SangHyeon-Shin/Pond-Water-Quality-IOT-System/docs/hardware.md

# 하드웨어·배선·전원

부품 목록과 가격은 [`hardware/bom.xlsx`](../hardware/bom.xlsx)([CSV](../hardware/bom.csv))에 있습니다.

## 1. 연못 노드 (Arduino Uno)

| 신호 | Uno 핀 | 비고 |
|---|---|---|
| 탁도 SEN0189 신호 | **A0** | 센서 보드 스위치를 **A(아날로그)** 로 둡니다 |
| TDS 신호 | **A1** | VCC는 5V, 또는 간섭 대책 시 **D5** (4절) |
| pH 보드 신호 | **A2** | 보드 세대(V1/V2)는 `PH_BOARD_VERSION` |
| 용존산소 SEN0237 신호 (선택) | **A3** | `ENABLE_DO_SENSOR 1` |
| DS18B20 DATA | **D2** | 4.7 kΩ 풀업을 5V에 연결 |
| TDS 보드 VCC (선택) | **D5** | `PIN_TDS_POWER 5` (TDS 보드 소비전류 3~6 mA) |
| 릴레이 IN (선택) | **D6** | `ENABLE_AERATOR_CONTROL 1` (6절) |
| nRF24 CE / CSN | **D7 / D8** | |
| nRF24 SCK / MISO / MOSI | **D13 / D12 / D11** | SPI 버스. D13(내장 LED)은 다른 용도로 쓰지 않습니다 |
| nRF24 어댑터 보드 VCC | **5V** | 어댑터의 3.3V 레귤레이터 사용, 10~100 µF 커패시터 추가 |

모든 핀은 [`firmware/pond_node/config.h`](../firmware/pond_node/config.h)에서 바꿀 수 있습니다.
2024년 회로도(TDS 전원 제어·DO·릴레이 이전 구성): [`images/circuit-2024.png`](images/circuit-2024.png)

## 2. 게이트웨이

### A. NodeMCU V2 (권장, BOM에 이미 있음)

| nRF24 (어댑터 보드) | NodeMCU |
|---|---|
| CE | **D2** (GPIO4) |
| CSN | **D1** (GPIO5) |
| SCK | **D5** (GPIO14) |
| MISO | **D6** (GPIO12) |
| MOSI | **D7** (GPIO13) |
| VCC | USB 5V가 나오는 핀(Amica V2: VIN, LoLin V3: VU) |
| GND | GND |

Uno와 ESP-01 두 보드를 NodeMCU 1장으로 대체합니다. AT 펌웨어, SoftwareSerial이 필요 없고 RAM이 충분합니다.
어댑터 입력 전압이 4.5 V 이상인지 멀티미터로 확인하세요(레귤레이터 강하 전압 때문).

### B. Arduino Uno + ESP-01 (2024 구성)

| 신호 | Uno |
|---|---|
| ESP-01 TX → | **D2** (SoftwareSerial RX) |
| ESP-01 RX ← | **D3** (SoftwareSerial TX, 어댑터 보드의 레벨 변환 경유) |
| nRF24 CE / CSN / SPI | 노드와 동일 (D7 / D8 / D11~13) |

ESP-01은 AT 펌웨어 보드레이트를 9600으로 한 번 설정해야 합니다([blynk-setup.md](blynk-setup.md#4-esp-01-at-펌웨어-설정-uno-게이트웨이만)).

## 3. 무선 링크 (nRF24L01+PA+LNA)

양쪽 설정은 [`PondProtocol.h`](../firmware/libraries/PondCore/src/PondProtocol.h) 한 곳에 있어 항상 일치합니다.

| 항목 | 2024 | 현재 | 근거 |
|---|---|---|---|
| 데이터율 | 1 Mbps (기본값) | **250 kbps** | 수신감도 −85 → **−94 dBm** (nRF24L01+ 데이터시트) |
| 출력 | `PA_LOW` | **`PA_HIGH`** | 연못↔교실 거리. 전원 불안정 시 `PA_LOW`로 되돌리고 커패시터 확인 |
| 채널 | 76 (암묵적) | **76 (명시)** | 2,476 MHz |
| 페이로드 | 32 B 고정, 16 B 사용 | **29 B** (버전·순번·상태 포함) | |
| 재전송 | 15회 | 15회, 1.5 ms 간격 | 250 kbps에 필요한 간격 |

- **채널 선택**: nRF24 채널 n은 2400+n MHz입니다. 2.4 GHz ISM 대역은 2,483.5 MHz까지이므로 **0~83번만** 사용합니다(84 이상은 대역 밖). Wi-Fi 1/6/11번 채널은 대략 2,401~2,473 MHz를 차지하므로 74~83번이 겹침이 적습니다. 현장 Wi-Fi 채널은 스캐너 앱으로 확인하세요.
- **복제 칩**: 시리얼에 `data rate not supported`가 나오면 250 kbps를 지원하지 않는 칩입니다. 양쪽 모두 `RF24_1MBPS`로 바꿉니다.
- 안테나는 수직으로 세우고, 금속 함체 밖으로 내고, 가능하면 시야를 확보합니다.

## 4. pH·TDS 간섭

TDS 프로브는 물에 교류 신호를 흘려 측정하므로, 같은 물에 있는 pH 전극 측정을 흔들 수 있습니다.
DFRobot도 두 센서를 같은 용기에서 함께 쓸 때 간섭을 안내하고 신호 절연 모듈(DFR0504)을 판매합니다.
2024 회로도는 두 프로브를 다른 비커에 두었지만, 현장에서는 한 묶음으로 같은 물에 넣었습니다.

| 방법 | 비용 | 설정 |
|---|---|---|
| **TDS 전원 시분할** (권장, 추가 부품 없음) | 0원 | TDS 보드 VCC를 5V에서 **D5**로 옮기고 `PIN_TDS_POWER 5`. 노드는 TDS를 끈 채로 pH·탁도·DO를 측정한 뒤, TDS를 켜고 2 s 예열 후 측정하고 다시 끕니다 |
| 신호 절연 모듈 DFR0504 | 별도 구매 | pH 보드와 Uno 사이에 연결 |

간섭 여부는 물 한 컵에서 TDS 프로브를 넣었다 뺐다 하며 유지보수 모드(`status`)의 pH 전압 변화를 보면 확인할 수 있습니다.

## 5. 전원

### 소비전류 (참고치)

| 부하 | 전류 | 출처 |
|---|---|---|
| Arduino Uno 보드 | 동작 약 50 mA, 슬립 약 35 mA | 공개 측정 사례(USB 칩·레귤레이터·LED가 슬립 중에도 소비) |
| 탁도 SEN0189 | 최대 40 mA, 상시 | 제조사 사양 |
| TDS 보드 | 3~6 mA | 제조사 사양. D5 전원 제어 시 측정 중에만 |
| DS18B20 | 1.5 mA 이하(변환 중) | 데이터시트 |
| nRF24 PA+LNA | 송신 순간 최대 약 115 mA | 모듈 사양. 현재 펌웨어는 60 s마다 수 ms만 켜고 나머지는 powerDown |
| 릴레이 코일 (선택) | 약 70 mA | NC 배선이면 폭기를 끌 때만 통전 |

| 펌웨어 | 평균 전류 (추정) | 10,000 mAh 보조배터리 (약 31 Wh 사용 가능 가정) |
|---|---|---|
| 2024 (쉬지 않고 송신·재전송) | 약 110~160 mA | 약 1.5~2.5일 |
| 현재 (60 s 주기, 슬립, 무선 powerDown) | 약 75~90 mA | 약 3~3.5일 |

추정치이므로 USB 전류계로 실측해 보세요. 남은 큰 소비는 **Uno 보드 자체**와 **상시 켜진 탁도 센서**입니다.
더 줄이려면 센서 전원을 MOSFET으로 차단하거나 저전력 보드(3.3 V Pro Mini 등)로 바꿔야 합니다(하드웨어 변경).

- **보조배터리 자동 꺼짐**: 일부 보조배터리는 부하가 수십 mA 이하로 떨어지면 출력을 끕니다. 슬립 후 노드가 멈추면 "저전류/IoT 모드"가 있는 제품을 쓰거나 아래 태양광 구성을 사용하세요.
- **태양광 구성 (개략 계산)**: 평균 0.4 W × 24 h ≈ **10 Wh/일**. 2일 무일조 대비 배터리 약 20 Wh(18650 3,000 mAh 2개 병렬 ≈ 22 Wh), 패널은 하루 일사 3~4시간·효율 70 % 기준 약 4 W가 필요하므로 여유를 두어 **10 W**, 태양광 충전 컨트롤러 + 5 V 승압기를 사용합니다.

## 6. 폭기 장치 릴레이 (선택)

```
태양광 폭기 키트 출력(+) ──── 릴레이 COM
                              릴레이 NC ──── 펌프(+)
태양광 폭기 키트 출력(−) ─────────────────── 펌프(−)
```

- **NC(상시 닫힘) 접점**에 연결합니다. 릴레이가 꺼져 있으면(노드 고장·전원 차단 포함) 펌프가 계속 돕니다.
  펌웨어 설정 `AERATOR_ON_WHEN_RELAY_ENERGIZED 0`이 이 배선에 맞춘 기본값입니다.
- 릴레이 접점 정격이 펌프 전류보다 커야 합니다(38 W 키트라면 키트 전압 기준 전류를 계산하세요).
- 대부분의 5 V 릴레이 모듈은 IN이 LOW일 때 동작합니다(`RELAY_ACTIVE_LOW 1`).
- 동작: DO < 5.0 mg/L이면 즉시 ON, DO > 7.0 mg/L이고 15분 이상 돌았으면 OFF.
  **DO가 무효이거나 DO 센서가 교정 전이면 항상 ON**입니다. 기준값은 `config.h`에서 조정합니다.

## 7. 설치·방수·유지관리

- 함체의 케이블 인입부는 **케이블 글랜드**로 막고 실리카겔을 넣습니다.
- 탁도 센서 상단(전자부)은 방수가 아니므로 물 밖에 두고(3D 프린팅 홀더), 직사광선을 가립니다.
- 프로브는 가장자리·바닥 침전물에서 떨어진 일정 깊이(예: 20~30 cm)에 고정합니다. 2024 현장 시험은 가장자리 수초 사이였습니다.
- 권장 점검 주기: 탁도 광학창·TDS 전극 세척 매주, pH 재교정 매월(전극은 마르지 않게 보관).
