SangHyeon-Shin/Pond-Water-Quality-IOT-System/CHANGELOG.md

# 변경 내역

## v2.0.0 — 2026-10-31

2024 버전 코드 리뷰(2026-10)에서 확인한 문제를 반영했습니다.
2024 코드는 커밋 `37dee70`에서 볼 수 있습니다.

### 보안

- Blynk 토큰과 Wi-Fi 비밀번호를 코드에서 제거하고 `secrets.h`(git 제외)로 분리했습니다.
  `secrets.h`가 없으면 컴파일이 안내와 함께 멈추고, CI가 토큰 하드코딩을 검사합니다.
  **이미 공개된 값의 폐기는 저장소 소유자가 직접 해야 합니다** → [SECURITY.md](SECURITY.md)

### 측정 정확도 (연못 노드)

| 2024 동작 | 영향 | 수정 |
|---|---|---|
| TDS 온도보상에 쓰는 전역 `temperature`에 값이 대입되지 않음 → 0 °C로 계산, 보상계수 0.5 | TDS 과대: 수온 2 °C에서 1.07배, 30 °C에서 2.09배. Blynk 화면의 179.71 ppm은 실제 약 96 ppm | 측정 수온으로 보정. 수온이 무효면 25 °C로 보정하고 상태 비트 표시 |
| `ADC_NTU[i] >= z;`가 효과 없는 문장(`if` 누락) | 탁도가 원시값 1개 | 20개 샘플 강건 평균 |
| 탁도 직선식이 교정되지 않음, 음수 처리 없음 | 맑은 수돗물이 약 146 NTU | 2점 교정, 0 미만 차단. 교정 전 값은 상태 비트로 구분 |
| pH `Offset 0.00`, V1 예제식만 사용 (BOM은 V2 보드) | 교정 없음 | V1/V2 모두 쓰는 2점 교정, EEPROM 저장 |
| 루프당 `getTemp()` 2회, 변환 대기 없음, CRC 미검사, 오류값 −1000 송신 | 이전 변환값이나 85 °C(전원 투입값)를 읽을 수 있음, 그래프에 가짜 값 | 측정 1회, 750 ms 대기, CRC 검사, 오류는 NaN + 상태 비트 |
| pH·TDS 프로브를 같은 물에서 동시에 구동 | 상호 간섭 가능 | TDS 전원 시분할 옵션 `PIN_TDS_POWER` |
| ADC 기준을 5.00 V로 고정 가정 | 공급전압 3 % 오차 = pH 약 0.2 오차 | 내부 기준으로 공급전압 측정(`cal vcc`로 보정) |
| pH 평균 배열이 0으로 시작 | 기동 직후 약 40회 pH 과소 | 측정마다 새 샘플 40개 |

### 통신·전력

- 송신 주기: `lastSampleTime`이 갱신되지 않아 초당 약 11회 송신하던 것을 **60초에 1회**로 바꿨습니다.
  2024 구성을 모델링한 시뮬레이션에서 송신의 약 90 %가 재전송 실패였습니다.
- 게이트웨이가 수신 버퍼를 매번 모두 비웁니다(2024: 1초에 1개만 읽어 나머지 손실·지연).
- 무선: 250 kbps(수신감도 −85 → −94 dBm), `PA_HIGH`, 채널·페이로드·재전송을 명시하고 모듈 응답을 확인해 재초기화합니다.
- 측정 사이에 슬립하고 무선 모듈을 끕니다. 평균 전류 추정 110~160 mA → 75~90 mA.
- 노드 무응답 감지(V8, `node_offline` 이벤트). 무효 값은 대시보드로 보내지 않습니다.
- 게이트웨이가 Wi-Fi 실패 시 `setup()`에서 무한 대기하지 않습니다.
- 패킷 v2(29 B): 버전, 노드 ID, 순번(손실률 계산), 상태 비트, 공급전압, DO, 폭기 상태를 추가했습니다.

### 새 기능

- 시리얼 유지보수(교정) 모드. 이 모드에서는 무선 송신과 슬립이 꺼집니다.
- 용존산소 센서 지원(선택). DO 기반 폭기 릴레이 제어(선택): NC 배선 fail-safe, DO가 무효이거나 교정 전이면 항상 ON.
- 수질 경보 이벤트(`water_quality_alert`). 미교정·무효 값은 제외하고 같은 종류는 6시간 간격으로 보냅니다.
- NodeMCU 1장 게이트웨이(권장, BOM에 있던 부품).
- `tools/aeration_effect.py`: 게이트웨이 CSV 로그로 폭기 ON/OFF 비교(같은 시간대 차이, 변화율).

### 저장소

- 구조: `firmware/{pond_node, gateway_nodemcu, gateway_uno_esp01, libraries/PondCore, test}`, `docs/`, `hardware/`, `tools/`.
- 공통 코드 PondCore: 패킷 정의 한 곳, 단위 테스트 15종(검사 199개).
- GitHub Actions: 단위 테스트, 세 스케치 실제 컴파일(Uno 2, NodeMCU 1), 인증정보 검사.
- README 재작성(상대경로 이미지, 실제 구성 기준 구성도), 문서 3종, MIT 라이선스, SECURITY.md.
- 사진 재압축: 7장 합계 5.68 MB → 1.57 MB (게이트웨이 사진 3.03 MB → 0.32 MB).
- BOM: 실제로 쓰였지만 빠져 있던 게이트웨이 부품 추가, 용도·비고 열 추가, CSV 사본. 가격을 확인하지 못한 항목은 비워 두었습니다.

### 검증 (개발 환경)

- PondCore 단위 테스트: g++ `-Wall -Wextra -Werror`, AddressSanitizer/UBSan, 199개 검사 통과.
- Uno 컴파일(avr-gcc 7.3, AVR core 1.8.6, RF24 1.6.2, OneWire 2.3.8, DallasTemperature 4.0.6, Blynk 1.4.0), 프로젝트 코드 경고 0개:

  | 스케치 | 플래시 | RAM | 2024 대비 RAM |
  |---|---|---|---|
  | pond_node (기본) | 19,098 B (59 %) | 648 B (31 %) | 753 B → 648 B |
  | pond_node (DO·폭기·TDS 전원 제어 모두 사용) | 21,400 B (66 %) | 648 B (31 %) | |
  | gateway_uno_esp01 | 28,662 B (88 %) | 1,265 B (61 %) | 1,085 B → 1,265 B |
  | gateway_nodemcu (ESP8266 core 3.1.2, GitHub Actions) | 261,180 B (24 %) | 30,384 B (37 %) | 신규 |

  GitHub Actions의 arduino-cli 빌드도 pond_node에서 같은 크기(19,098 B / 648 B)를 보고했습니다.

- 노드 스케치를 수정 없이 PC 모의 하드웨어에서 실행해 확인한 시나리오:
  - 정상 10분: 60초 간격 10패킷, pH 7.04 / TDS 69.4 ppm / 탁도 145.66 NTU(2024 알파 로그와 같은 원시값 기준)
  - 교정 명령 6종 성공, 잘못된 명령·범위 밖 입력 거부, 유지보수 중 무송신
  - 재부팅 후 교정값 유지
  - DS18B20 없음, 게이트웨이 다운, pH·탁도 단선, 무선 모듈 없음 → 복구
  - DO 기반 폭기 제어
- 실제 하드웨어 시험은 하지 않았습니다. 업로드 후 교정과 현장 재시험이 필요합니다.

## v1.0 — 2024-05-26 (커밋 `37dee70`)

최초 공개. Arduino Uno 송신기(수온·pH·TDS·탁도) + Uno/ESP-01 수신기, Blynk 대시보드, 현장 시험 기록.
