SangHyeon-Shin/Pond-Water-Quality-IOT-System/firmware/gateway_nodemcu/secrets.example.h

// Copy this file to secrets.h (ignored by git) and fill in your own values.
// Never commit secrets.h. See SECURITY.md.
#pragma once

// Blynk console > Device > Device info
#define BLYNK_TEMPLATE_ID "TMPLxxxxxxxxx"
#define BLYNK_TEMPLATE_NAME "Pond Water Quality"
#define BLYNK_AUTH_TOKEN "YourDeviceAuthToken"

#define WIFI_SSID "YourWiFiName"
#define WIFI_PASS "YourWiFiPassword"
